yyy006006006/ergoSHIFT-ChocV2/hardware-rev1/README.md

## nekoko edition: Choc V1 / V2 PCB

For this modified PCB, use the [KiCad source](./design_data/ergoSHIFT-rev1-ChocV1-V2-Standard-BSocket-kicad/) and [Gerber ZIP](./ergoSHIFT-rev1-ChocV1-V2-Standard-BSocket-gerber.zip).
Mechanical holes for Kailh Choc V1 / V2 and a back-only socket footprint have been added, preserving the original outline, key positions, mounting holes, and MCU connections.
This is the standard right-handed layout only. Mount switches on the front and 15 Kailh CPG135001S30 sockets on the back.
Direct switch soldering is not supported, and the original reversed-assembly instructions do not apply to this version.
The MCU footprint is for an ATmega32U4 Pro Micro. Use the existing [Rev1 firmware](../firmwares_atmega32u4/), rather than the RP2040 firmware for Rev2.

Saved validation results from 2026-10-02 show 0 DRC errors, 0 unconnected items, and 0 schematic/PCB parity findings.
Remaining findings are 34 DRC warnings (6 silkscreen-to-edge clearance, 4 library footprint mismatches, and 24 silkscreen-over-copper), 1 ERC error (power pin not driven), and 21 ERC warnings.
No check exclusions were added and no rules were relaxed. These results do not establish that every physical button works or that every switch and case will fit.

Modified by nekoko / [yyy006006006](https://github.com/yyy006006006); prepared for publication on 2026-10-18.
Original design: ergoSHIFT (c) by [mizma](https://github.com/mizma/ergoSHIFT). The modified design is also licensed under [CC BY-SA 4.0](https://creativecommons.org/licenses/by-sa/4.0/).
The original Rev1 documentation follows.

---

ergoSHIFT rev1
========================================================================

This is rev1 of the ergoSHIFT.  In this version an Arduino Pro Micro
is soldered onto the main PCB.

To make one you will need:

* [acrylic shell](./acrylic-shell/)
    * For Standard Layout
        * Layers 1, 2, 4: 3mm
        * Layers 3, 5: 2mm
    * For Reverse Layout (Left handed)
        * Layers 1, 2, 3: 3mm
        * Layers 4, 5: 2mm
* [the ergoSHIFT PCB](./pcb/)
* Arduino Pro Micro [SparkFun Qwiic Pro Micro - USB-C (ATmega32U4)](https://www.sparkfun.com/products/15795)
* 15x Kailh low profile (choc v1) switches of your choice
    * I use Kailh Choc v1 Red Pro (Linear and low activation force: 35±10gf with actuation travel: 1.5±0.5mm)
    * Light Blue (gChoc) can be used for even lower actuation force.
* (optionally) 15x Kailh low profile hotswap sockets
* Button Caps (Choose one)
    * [MICRO keycap set](https://junkfoodarcades.com/collections/micro-accessories)
        * You will need to buy two sets of Snackbox Micro keycap sets.
    * [3D printed buttoncaps](../3d-printed-buttoncaps)
* 3x 6x6x8.51mm tact switches
    * I Used [TE Connectivity 3-1825910-5](https://www.te.com/ja/product-3-1825910-5.html)
* 1x 3x6x4.3 horizontal tact switch
    * https://www.newegg.com/p/2S7-01KR-035X0
    * https://shop.yushakobo.jp/collections/all-keyboard-parts/products/a1600ed-01-1
    * [schematics](images/tactile-switch_3x6x4.3.jpg)
* 7x M3 screws (length 20mm)
    * Acryl top 2mm * 2 + 3mm = 7mm
    * PCB 1.6mm
    * Acryl bottom 3mm * 2 = 6mm
    * Rubber feet screw depth = 3mm (using rubber feet below.  adjust for your part)
    * Rubber feet total depth = 8mm (using rubber feet below.  adjust for your part)
    * M3 nut height = 2mm
    * min length = 19.6mm (using rubber feet below.  adjust for your part)
    * max length = 22.6mm (using rubber feet below.  adjust for your part)
* 7x M3 nut and acompanying rubber feet
    * Rubber feet Tochigiya [TM-TK-15](https://www.monotaro.com/p/0933/2486/?displayId=5)
    * The position of the holes are intended for feet radius of less than 8mm
* Some Tin coated wires
* a soldering iron
    * something with enough power is better 
      (i.e. [Hakko FX 600](https://www.hakko.com/japan/products/hakko_fx600_set.html))
    * I recommend changing tips to D type for most Through-hole soldering, or C type if you plan to
      solder SMT as well. (default B tips are harder to use for most PCB soldering)
    * Use 320C ~ 370C temp recommended (can be changed if you know your way around)

## Assembly Instructions

### Ordering PCB

I used [JLCPCB](https://jlcpcb.com/).  Just upload the gerber files in [pcb](pcb) and keep most parameters default.
You may change PCB Qty and PCB Color if you like.  All other parameters should be kept the same.

### Ordering Buttons

#### Snackbox Micro button caps

ergoSHIFT is compatible with Snackbox Micro button caps.

You can purchase them [HERE](https://junkfoodarcades.com/collections/micro-accessories)

#### 3D printed buttons

_**Currently verifying design**_

If you have a 3D printer, print at your own will.  Files are found [here](../3d-printed-buttoncaps/).

* [ergoSHIFT-ButtonCapBig.stl](../3d-printed-buttoncaps/ergoSHIFT-ButtonCapBig.stl) 
  is used for the thumb button. 1 board needs 1 of this button.
* [ergoSHIFT-Buttoncap.stl](../3d-printed-buttoncaps/ergoSHIFT-ButtonCapBig.stl) is used for all other buttons.
  1 board needs 14 of this button.
* [ergoSHIFT-FullSetButtonCaps.stl](../3d-printed-buttoncaps/ergoSHIFT-FullSetButtonCaps.stl) is an STL file 
  containing 1 full set of buttons + extra(26 small and 2 big.).  If your 3D printing service allows 28 or more shells, it may be cheaper to print in one batch using this STL file.
    * Print size needs to be bigger than X：99.4901mm x Y： 91.7951mm x Z： 15.0000mm
    * To accomodate for the buttons in the 100mm x 100mm x 100mm size limit in some Printing services,
      This STL file has two layers of buttons arranged on top of each other.  This type of layout is only
      possible on print technology such as SLS or MJF.  Check with your 3D Printing service.
    * If your 3D Printing service does not support this type of data, use individual cap data to print.

Insertion portion may need to be adjusted in size for your 3D Printer and settings to fit snugly to the switch.
You may use some of the printer features but if that doesn't work, you might want to edit the original model.
Model data are found in [here](../3d-printed-buttoncaps/design_data/) in a [FreeCAD](https://www.freecadweb.org/)
file format.

Also, since the insertion portion requires a fairly tight tolerance which is not easily achieved by 3D printers,
the models are modelled slightly on the larger side.

I have had fairly good results with this model using SLS/MJF Nylon print but sometimes it is too large.
If the legs turn out too large to fit, use sandpaper to adjust the width of the legs.

#### Materials Consideration

* Nylon
    * May be a good place to start for tensile strength and good chemical stability.
    * can be pretty strong if printed using SLS process at some printing services
    * may be prone to warping.  not good for humid places.
* UV Resin
    * Also pretty strong as a material, and stronger to humidity.
    * Maybe slightly more brittle than Nylon

### Ordering Acrylic cuts

I use [Elecrow](https://www.elecrow.com/acrylic-cutting.html) to cut acrylic.

Upload the .zip file in [acrylic-shell](acrylic-shell/) to the Elecrow Acrylic cut service to order.
.Zip file includes the dxf file and the dimentions.txt file.  PDF is just for reference.

Use the following thickness:

* For Standard Layout
    * Layers 1, 2, 4: 3mm
    * Layers 3, 5: 2mm
* For Reverse Layout (Left handed)
    * Layers 1, 2, 3: 3mm
    * Layers 4, 5: 2mm

The original design file (FreeCAD file) can be found [here](./design_data/acryl-design/).

The Acrylic should look like the following (with PCB stacked)

ergoSHIFT-rev1-Acrylic-Stack

(*) Above image is for standard layout (right handed)

### Assembly

1. Solder all the Choc v1 switches and the tactile switches.  make sure you populate the side with the logo.
    * If you populate the side with the logo on the left, the parts only goes in in the correct orientation.
        * For reverse layout, implement the buttons on the other side as shown in [this picture](images/Reverse-Layout-Solering.jpg)
    * If you use the hot-swap sockets, those will go on the back. (see silk screen on back side for orientation)
        * For hotswap sockets, pre-solder one side of the pad on PCB, place the socket, heat the pre-solder while
          pressing down on the socket to attach the socket.  After It is attached, solder the other side fully and then add more solder on the pre-soldered side.
2. Solder the Pro Micro Qwiic from the bottom side of the PCB up into the slit (USB socket should be between the cut-outs on the board, facing up) (Following instruction is how I did it.  There may be other ways) (This should NOT BE REVERSED for left hand layout)
    1.  First, mask the back side holes on the PCB with masking tape, and poke a small hole in each Through-hole with a needle. (This is to stop creating solder filets on the side the ProMicro will be soldered to.
        Mask Through-holes
    2. Insert a short (2~3cm) tin coated wire in the hole and solder onto the board.  Then cut the excess wire on the front side.
       Tin Coated Wires
       Place Wire
       Solder backside
    3. Remove the masking tape.  The back side should have a flat solder filled hole with wires coming out the middle.
       Flat Filled Through-holes
    4. Place the Pro-Micro into the wires, tape it down to place.  Also tape the entire front side of 
       the soldered through-holes so the wires don't fall when solder melts.
       Place Pro-Micro into Wires
    5. Solder the Pro-Micro to the tin-coated wire.
       Soldered Pro-Micro
3. stack the Acryl and PCB in following order: Layer 01, Layer 02, PCB, Layer 03, Layer 04 and Layer 05.
    * If you use 2 Layer 4s, the order should be 01, 02, 03, 04, 04.
4. Screw on the M3 screws with the nut on all 7 locations.  Rubber feet should be inserted at least in the 4 corners between the nut and the acrylic.

It should look like the following when assembled.

ergoSHIFT-rev1
ergoSHIFT-rev1

### Pro-Tip 1. Filing the Acrylic Edges

Acrylic Edges after laser cutting can be quite sharp and do not feel good.
You may want to file the edges with sandpaper (#400 is a nice place to start) to remove the edges 
on the top acrylic layer so it does not feel bad.

### Pro-Tip 2. Customizing design

You can also insert some artwork below the top acrylic layer as below:

ergoSHIFT-rev1_with_artwork1
ergoSHIFT-rev1_with_artwork1
ergoSHIFT-rev1_with_artwork2

(*) Above sample Artwork based on an In-Game Screenshot + Official Fan-kit (©Cygames & ARK SYSTEM WORKS)

Stencil for the artwork can be found below (Page size set to A4):

* [Stencil SVG](./images/ergoSHIFT-stencil.svg)
* [Stencil PNG 300dpi](./images/ergoSHIFT-stencil.png)
* [Southpaw Stencil SVG](./images/ergoSHIFT-stencil-reverse.svg)
* [Southpaw Stencil PNG 300dpi](./images/ergoSHIFT-stencil-reverse.png)

To cut the stencil, use one of the top acrylic plates as cutting guides (don't trust the acuracy
of the printed stencil mark, they are good enough to use as design guide, but not acurate enough for 
final cutting guide).  It is easy to cut if you tape the plate on top of the print and use a sharp
designers knife.

Stencil-Cutting

## License and Acknowlegements



PCB design licensed under [CC BY-SA 4.0](https://creativecommons.org/licenses/by-sa/4.0/) by mizma

Acrylic sandwitching shell heavily inspired by [Mille-Feuille](https://pomegd.booth.pm/items/2685530) 
by [@pomegd](https://twitter.com/pomegd)

PCB design uses the following libraries or derivatives of the design:

* [keyswitches.pretty](https://github.com/daprice/keyswitches.pretty) by [daprice](https://github.com/daprice) ([CC BY-SA 4.0](https://creativecommons.org/licenses/by-sa/4.0/))
* [ProMicroKiCad](https://github.com/Biacco42/ProMicroKiCad) by [Biacco42](https://github.com/Biacco42), derived from [teensy\_library](https://github.com/XenGi/teensy_library) by Ricardo Band ([MIT License](https://opensource.org/licenses/mit-license.php))
