yyy006006006/ergoSHIFT-ChocV2/firmwares_atmega32u4/LUFA/README.md

[日本語はこちら](README_ja.md)

## LUFA Switch/XInput hybrid Fightstick firmware

This firmware is a derivative of the awesome [LUFAHybridFightstick](https://github.com/CrazyRedMachine/LUFAHybridFightstick) by [CrazyRedMachine](https://github.com/CrazyRedMachine)

## nekoko Web configuration firmware (experimental)

The `nekoko-webconfig-v1.hex` build adds browser-based remapping for the 11 large buttons on the **Rev1 Choc V1/V2 Standard-BSocket** board. Modified by nekoko on 2026-10-18. The changes are in `NekokoMapping.*`, `NekokoConfig.*`, `LUFAHybridFightstick.ino`, `Descriptors.c`, and `XS_HID.c`. Source and firmware remain under the [GPL v3 license](LICENSE).

Install this firmware before shipping an assembled controller. Buyers do not reflash the firmware to change their button assignments. They hold the middle of the three small upper buttons while connecting USB, open the web configurator in desktop Chrome or Edge, and connect to **ergoSHIFT Configuration**. They select the physical button in the upper diagram, select an Xbox-style input in the lower diagram, and choose **Save to device**. Unplug and reconnect normally to resume playing. Direction controls, HOME, START, and existing SOCD handling remain fixed. The web app reads the stored map back before reporting a successful save.

The [web app source](../../web-configurator/) includes the on-screen connection guide and JSON backup/import. Configuration is stored in two alternating EEPROM records at addresses 32 and 64; legacy mode settings at addresses 0–9 are preserved. Normal XInput/Switch USB descriptors are retained; configuration mode uses a vendor-defined HID collection and the existing Switch-mode VID/PID. No new USB ID allocation is implied.

Validation so far: host-side C mapping tests, invalid-data rejection, 25 interrupted-save points, browser UI tests, AVR compilation, and Flash readback verification on the assembled controller. Holding the middle small button while connecting USB successfully entered configuration mode. Chrome read the stored mapping, saved a BACK/R3 swap, and read back the matching result over WebHID. After unplugging and reconnecting normally, Windows XInput recorded all three presses of the upper large button as R3, confirming that the saved mapping survived the power cycle. Other physical buttons and individual games have not yet been retested with this firmware. A double reset exposed this unit's Caterina COM port for about 7.5 seconds; a single reset did not expose a COM port in that observation. The original `LUFAHybridFightstick.ino.hex` is retained unchanged for recovery.

Build with Arduino CLI 1.5.1, the [Arduino-LUFA 0.93 board package](https://github.com/CrazyRedMachine/Arduino-Lufa/releases/tag/0.93), Bounce2 v2.71, and Arduino AVR GCC 7.3.0-atmel3.6.1-arduino7. Select `leonardo` (LUFA), ATmega32U4, 16 MHz. The current build uses 10,210 bytes of Flash and 466 bytes of static RAM. Only the application Flash is programmed; the bootloader, fuses, and EEPROM are not overwritten during installation.

## Source download and rebuild

The complete modified application source, the Arduino-LUFA platform/core, LUFA, EEPROM and Bounce2 2.71 sources used for the supplied build are included in this repository. Download the repository as a ZIP to obtain these files and [full licenses/notices](../../LICENSES.txt). The external general-purpose build tools are Arduino CLI 1.5.1 and AVR GCC 7.3.0-atmel3.6.1-arduino7 (avr-libc 2.0.0).

With PowerShell 7, Arduino CLI installed, and Arduino AVR Boards 1.8.6 installed for the compiler, run `./build-source.ps1` from this directory. `-ArduinoCli` and `-CompilerPath` can specify the installed tools. Output is `tmp/source-build/avr/LUFAHybridFightstick.ino.hex`. The script uses `source-dependencies/arduino-user` without modifying the user's Arduino configuration.

For installation on the tested ATmega32U4 / 16 MHz Pro Micro with Caterina, connect by USB, double-reset to expose its short-lived bootloader serial port, then flash the application HEX with avrdude using `-p atmega32u4 -c avr109 -P <bootloader-port> -b 57600 -D -U flash:w:<hex-path>:i`. Read back and verify Flash. Do not overwrite the bootloader, fuses or EEPROM. This unit has no signature lock or installation keys. Other bootloaders may require a different reset procedure. After flashing, connect while holding the middle small button to use WebHID configuration; reconnect without holding buttons to play.

Complete Corresponding Source and the installation information above are available for free download to anyone possessing the supplied software. This availability is maintained for at least three years after each product delivery and for as long as spare parts or support are offered for this model.

## Acknowledgments

This work is a fork of [LUFAHybridFightstick](https://github.com/CrazyRedMachine/LUFAHybridFightstick) by [CrazyRedMachine](https://github.com/CrazyRedMachine) and
is based on [fluffymadness' ATMega32U4-Switch-Fightstick](https://github.com/fluffymadness/ATMega32U4-Switch-Fightstick)
and [bootsector's XInputPadMicro](https://github.com/bootsector/XInputPadMicro), with a QoL features added by CrazyRedMachine.

This fork is customized for the needs of ergoSHIFT features

* Remapped keys to work with ergoSHIFT layout
* Removed support for analog stick
* reorganized the customization button settings for SOCD and other features
    * SOCD config is now only at startup and only provide three common modes (All Neutral, Hitbox and Gafro)
    * Added feature to configure vertical input inversion.  Useful when using Hitbox layout on non-fighting games.

## Features

### Gamepad modes

Hold "select" as you plug the controller to make it a Nintendo Switch controller.

Hold "start" as you plug the controller to make it an XInput controller.

Gamepad mode is persistent across plugging and unplugging the controller, so if you don't press anything while plugging the controller, it will stay in the last used mode. 

### DPAD modes

You can switch seamlessly between the 3 stick modes by pressing START+SELECT+(LEFT/UP/RIGHT)

- UP: DPAD 
- LEFT: Fake Left Analog (DPad is mapped to L-Analog)
- RIGHT: Fake Right Analog (DPad is mapped to R-Analog)

DPAD mode is also persistent.

### Real analog support

This function has been removed since ergoSHIFT has no plans of adding analog inputs

### Simulated home button

This is also removed since we have custom hardware that support home buttons

### SOCD Cleaning

* HOME at startup = All NEUTRAL
* RS at startup = Hitbox style SOCD cleaning (Up+Down=Up, Left+Right=Neutral)
* LS at startup = Gafro style SOCD cleaning (Up+Down=Up, Left+Right=Last Input)

You can use the Reset button on the ergoSHIFT while holding the buttons above to change mode.

### UP-DOWN inverse

Since ergoSHIFT is a Hitbox style controller, Up and Down button layout is a little convoluted for normal use outside its fighting game use-case.
I have added inverting the UP/DOWN input as a feature so the controller can be used a little easier on normal games... (although it still feels a little unweildy TBH.)

* To invert UP and DOWN inputs, press UP at startup.
* To set to normal mode, press DOWN at startup.

## Building Instructions

- Download Arduino IDE, 
- Download the Bounce2 Library inside the Arduino IDE
- Add `https://github.com/CrazyRedMachine/Arduino-Lufa/raw/master/package_arduino-lufa_index.json` as an Additional Board Manager URL (in `File -> Preferences` menu)
- Install LUFA AVR Boards from the Board Manager
- Select Arduino Leonardo (LUFA) as your board type (Pro-Micro is a compatible board to Leonardo)
- Upload the code and Have Fun

### How to upload

When you reflash AVR boards with USB HID device software, Arduino IDE cannot automatically reset and flash the software.
You will need to press reset button on the AVR board (SW_RST1 on ergoSHIFT) to put it into Bootloader mode to reflash.
When you use Sparkfun Qwiik ProMicro 5V, you will need to double-click the reset button to put it into Bootloader.

I recommend setting up VSCode Arduino plugin.  If you open this directory with VSCode, it is already set up so all you need to do is
run Arduino: Verify from the command pallet (You will still need to install Arduino, Bounce Library and add the LUFA board manager URL before you can run verify).
The .hex file will be created in the Build folder.

Take the .hex file and use [QMK Toolbox](https://github.com/qmk/qmk_toolbox) to flash the .hex file.

In QMK Toolbox, Press OPEN and select the .hex file you just created, (or just use the one in the repository).  Select ATMega32U4 from the dropdown menu at the top right corner.
Click the Reset button on the Pro-Micro (Double-Click on Qwiik ProMicro USB-C variant).  When you see the "Caterina device connected (usbser): ~~~" text, press Flash button.

This method, while requires extra software setups, is more reliable than trying to time the Reset while Arduino IDE is doing it's thing...

## Pinout

Configurable in the .ino

The key config is already setup to match ergoSHIFT wiring.

```C
/* PINOUT (follows Nintendo naming (X=up, B=down)) */
#define PIN_UP    7
#define PIN_DOWN  4
#define PIN_LEFT  3
#define PIN_RIGHT 5
#define PIN_A     MISO         //XBOX B
#define PIN_B     10           //XBOX A  
#define PIN_X     15           //XBOX Y
#define PIN_Y     MOSI         //XBOX X     
#define PIN_L     21           //XBOX LB
#define PIN_R     20           //XBOX RB
#define PIN_ZL    8            //XBOX LT
#define PIN_ZR    19           //XBOX RT
#define PIN_LS    6            //XBOX LS (left analog click)
#define PIN_RS    9            //XBOX RS (right analog click)
#define PIN_PLUS  2            //XBOX START
#define PIN_MINUS 18           //XBOX BACK
#define PIN_HOME  1
```

For southpaw version, swap the PIN_LEFT and PIN_RIGHT definition and recompile.

```C
/* PINOUT (follows Nintendo naming (X=up, B=down)) */
#define PIN_UP    7
#define PIN_DOWN  4
#define PIN_LEFT  5
#define PIN_RIGHT 3
#define PIN_A     MISO         //XBOX B
#define PIN_B     10           //XBOX A  
#define PIN_X     15           //XBOX Y
#define PIN_Y     MOSI         //XBOX X     
#define PIN_L     21           //XBOX LB
#define PIN_R     20           //XBOX RB
#define PIN_ZL    8            //XBOX LT
#define PIN_ZR    19           //XBOX RT
#define PIN_LS    6            //XBOX LS (left analog click)
#define PIN_RS    9            //XBOX RS (right analog click)
#define PIN_PLUS  2            //XBOX START
#define PIN_MINUS 18           //XBOX BACK
#define PIN_HOME  1
```

## Donation

If this project helped you, please consider going to the original works and donate to the source work ;)
