yyy006006006/ergoSHIFT-ChocV2/3d-printed-buttoncaps/design_data/ergoSHIFT-ButtonCapBig-ChocV2-MX.step

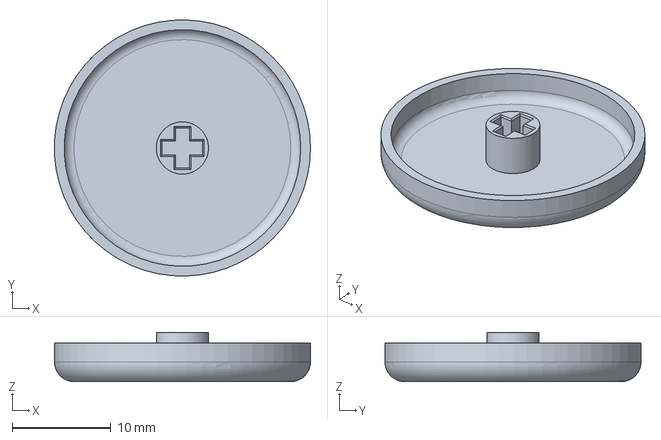
[picture p1: CAD file, 2026-10-18]
3d-printed-buttoncaps/design_data/ergoSHIFT-ButtonCapBig-ChocV2-MX.step
26.0 x 26.0 x 5.00 mm
