yyy006006006/ergoSHIFT-ChocV2/3d-printed-buttoncaps/design_data/ergoSHIFT-ButtonCap-ChocV2-MX.step

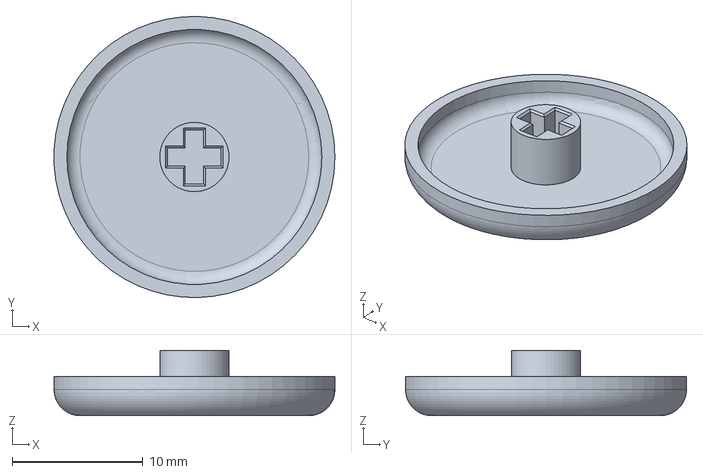
[picture p2: CAD file, 2026-10-18]
3d-printed-buttoncaps/design_data/ergoSHIFT-ButtonCap-ChocV2-MX.step
21.5 x 21.5 x 5.00 mm
