yyy006006006/ergoSHIFT-ChocV2/3d-printed-buttoncaps/ergoSHIFT-ButtonCap-ChocV2-MX.stl

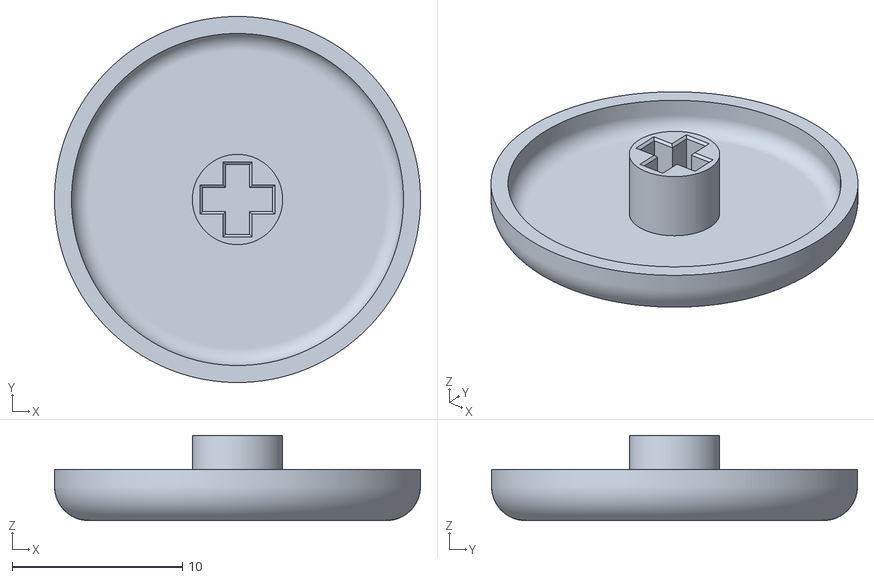
[picture p3: CAD file, 2026-10-18]
3d-printed-buttoncaps/ergoSHIFT-ButtonCap-ChocV2-MX.stl
21.5 x 21.5 x 5.00
