yyy006006006/ergoSHIFT-ChocV2/(list of files, cad)

Other CAD files:
3d-printed-buttoncaps/ergoSHIFT-ButtonCapBig-ChocV2-MX.stl
