yyy006006006/ergoSHIFT-ChocV2/hardware-rev1/design_data/ergoSHIFT-rev1-ChocV1-V2-Standard-BSocket-kicad/ergoSHIFT-rev1-ChocV1-V2-Standard-BSocket.kicad_pcb

## KiCad design hardware-rev1/design_data/ergoSHIFT-rev1-ChocV1-V2-Standard-BSocket-kicad/ergoSHIFT-rev1-ChocV1-V2-Standard-BSocket.kicad_pcb (2026-10-18)

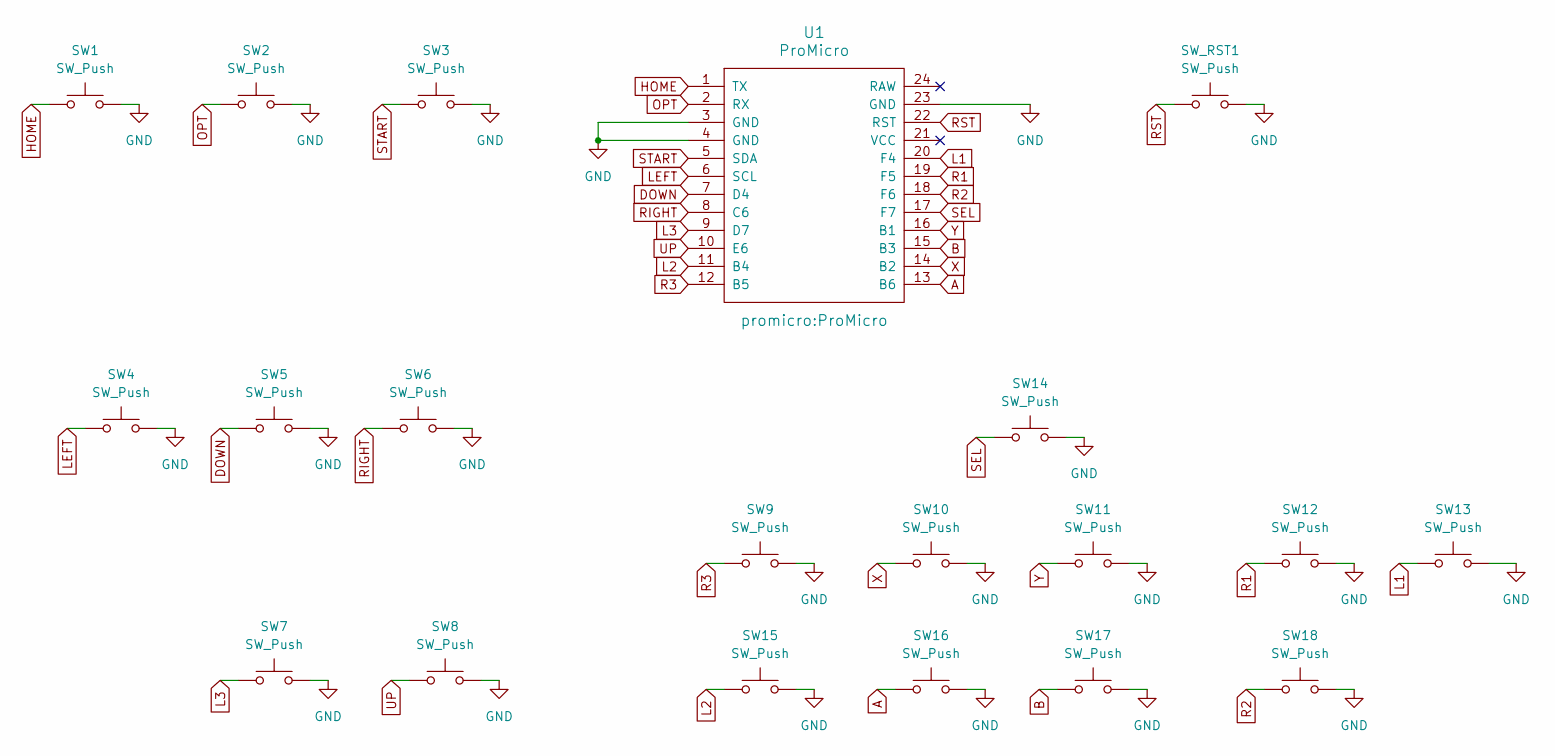
[picture p4: schematic ergoSHIFT-rev1-ChocV1-V2-Standard-BSocket.kicad_sch, ergoSHIFT]

Parts:
SW1, SW2, SW3: SW_Push; SW_PUSH_6mm_H8.5mm
SW4, SW5, SW6, SW7, SW8, SW9, SW10, SW11, SW12, SW13, SW14, SW15, SW16, SW17, SW18: SW_Push; SW_Choc_V1_V2_Standard_BSocket
SW_RST1: SW_Push; SW_Tactile_Yushakobo 3x6x4.3mm
U1: ProMicro

Connections:
A: SW16.1, U1.13 (B6)
B: SW17.1, U1.15 (B3)
DOWN: SW5.1, U1.7 (D4)
GND: SW1.2, SW2.2, SW3.2, SW4.2, SW5.2, SW6.2, SW7.2, SW8.2, SW9.2, SW10.2, SW11.2, SW12.2, SW13.2, SW14.2, SW15.2, SW16.2, SW17.2, SW18.2, SW_RST1.2, U1.3 (GND), U1.4 (GND), U1.23 (GND)
HOME: SW1.1, U1.1 (TX)
L1: SW13.1, U1.20 (F4)
L2: SW15.1, U1.11 (B4)
L3: SW7.1, U1.9 (D7)
LEFT: SW4.1, U1.6 (SCL)
OPT: SW2.1, U1.2 (RX)
R1: SW12.1, U1.19 (F5)
R2: SW18.1, U1.18 (F6)
R3: SW9.1, U1.12 (B5)
RIGHT: SW6.1, U1.8 (C6)
RST: SW_RST1.1, U1.22 (RST)
SEL: SW14.1, U1.17 (F7)
START: SW3.1, U1.5 (SDA)
UP: SW8.1, U1.10 (E6)
X: SW10.1, U1.14 (B2)
Y: SW11.1, U1.16 (B1)

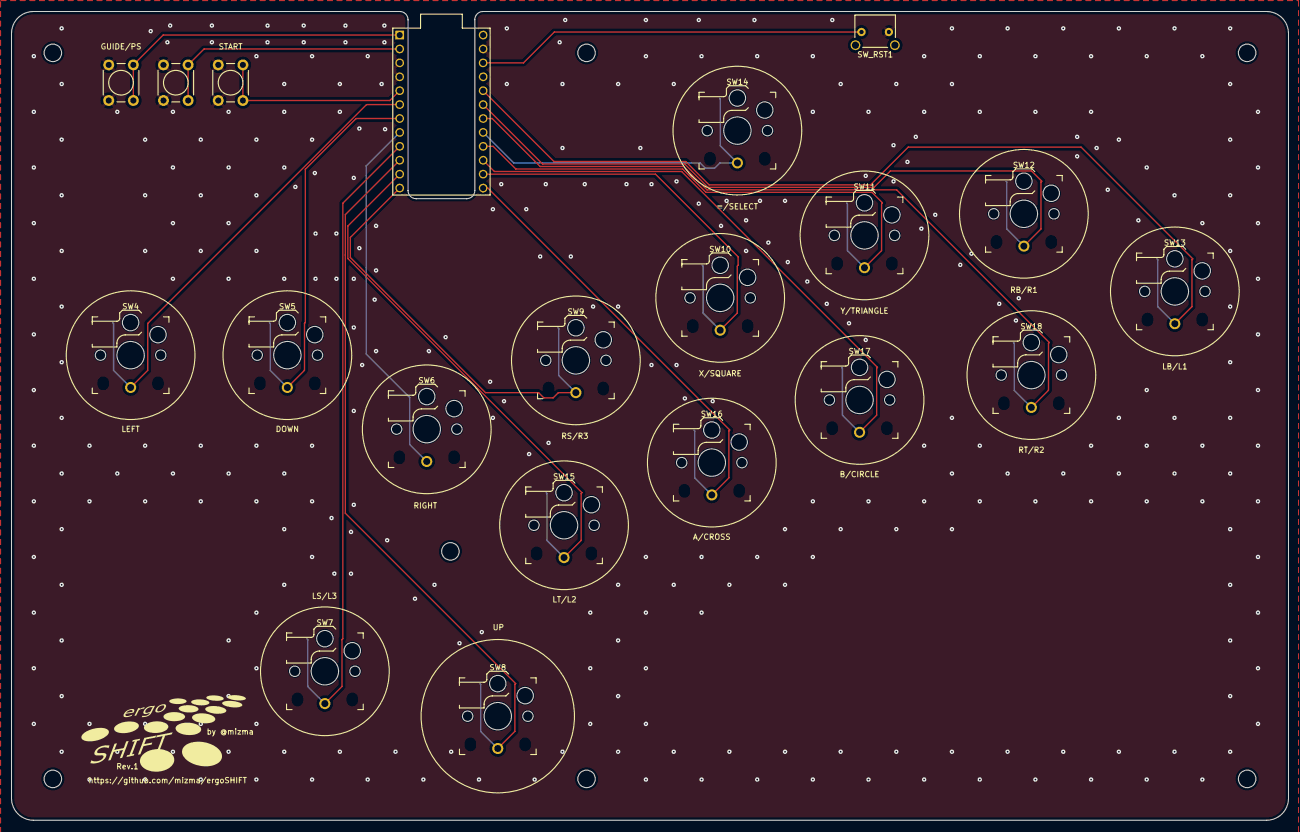
[picture p5: board ergoSHIFT-rev1-ChocV1-V2-Standard-BSocket.kicad_pcb from above]

Board: 2 copper layers, 233.2 x 147.7 mm, 20 parts (0 on the bottom side), 20 nets.
