yyy006006006/ergoSHIFT-ChocV2/firmwares_atmega32u4/LUFA/LUFAHybridFightstick/XS_HID.c

#include "XS_HID.h"
#include "NekokoConfig.h"
#include "NekokoMapping.h"
static USB_JoystickReport_Input_t ReportData;
static USB_JoystickReport_XInput_t XInput_ReportData;

// Configures hardware and peripherals, such as the USB peripherals.
void SetupHardware(bool xinput_mode) {
  
  //set xinput_mode for descriptors.h/.c
  xs_xinput = xinput_mode;
  desc_set_xinput_mode(xinput_mode);
  // We need to disable watchdog if enabled by bootloader/fuses.
  MCUSR &= ~(1 << WDRF);
  wdt_disable();
  // We need to disable clock division before initializing the USB hardware.
  clock_prescale_set(clock_div_1);
  // We can then initialize our hardware and peripherals, including the USB stack.
  // The USB stack should be initialized last.
  USB_Init();
}

// Fired to indicate that the device is enumerating.
void EVENT_USB_Device_Connect(void) {
  // We can indicate that we're enumerating here (via status LEDs, sound, etc.).
}

// Fired to indicate that the device is no longer connected to a host.
void EVENT_USB_Device_Disconnect(void) {
  // We can indicate that our device is not ready (via status LEDs, sound, etc.).
}

// Fired when the host set the current configuration of the USB device after enumeration.
void EVENT_USB_Device_ConfigurationChanged(void) {

  if (nekoko_config_mode) {
    Endpoint_ConfigureEndpoint(JOYSTICK_IN_EPADDR, EP_TYPE_INTERRUPT, 8, 1);
    return;
  }

  if (!xs_xinput) Endpoint_ConfigureEndpoint(JOYSTICK_OUT_EPADDR, EP_TYPE_INTERRUPT, JOYSTICK_EPSIZE, 1);
  else Endpoint_ConfigureEndpoint((ENDPOINT_DIR_IN | 3), EP_TYPE_INTERRUPT, 32, 1);
  
  Endpoint_ConfigureEndpoint(JOYSTICK_IN_EPADDR, EP_TYPE_INTERRUPT, xs_xinput? JOYSTICK_EPSIZE_XINPUT: JOYSTICK_EPSIZE, 1);

}

// Process control requests sent to the device from the USB host.
void EVENT_USB_Device_ControlRequest(void) {
  if (nekoko_config_mode) { nekoko_config_request(); return; }
  //No controlRequest received from the switch, so only handled in xinput mode 
 if (xs_xinput){
  /* Handle HID Class specific requests */
  switch (USB_ControlRequest.bRequest) {
  case HID_REQ_GetReport:
    if (USB_ControlRequest.bmRequestType
        == (REQDIR_DEVICETOHOST | REQTYPE_CLASS | REQREC_INTERFACE)) {
      Endpoint_ClearSETUP();

      /* Write the report data to the control endpoint */
      Endpoint_Write_Control_Stream_LE(&XInput_ReportData, 20);
      Endpoint_ClearOUT();
    }
    break;
  }
 }
}

// Process and deliver data from IN and OUT endpoints.
void HID_Task(void) {
    /* Device must be connected and configured for the task to run */
if (USB_DeviceState != DEVICE_STATE_Configured)
    return;

void* Address = &XInput_ReportData;
uint16_t    Size    = 20;

//no OUT endpoint for xinput in this firmware
if (!xs_xinput){
  Address = &ReportData;
  Size = sizeof(ReportData);
  
   // We'll start with the OUT endpoint.
  Endpoint_SelectEndpoint(JOYSTICK_OUT_EPADDR);
  // We'll check to see if we received something on the OUT endpoint.
  if (Endpoint_IsOUTReceived())
  {
    // If we did, and the packet has data, we'll react to it.
    if (Endpoint_IsReadWriteAllowed())
    {
      // We'll create a place to store our data received from the host.
      USB_JoystickReport_Output_t JoystickOutputData;
      // We'll then take in that data, setting it up in our storage.
      Endpoint_Read_Stream_LE(&JoystickOutputData, sizeof(JoystickOutputData), NULL);
      // At this point, we can react to this data.
      // However, since we're not doing anything with this data, we abandon it.
    }
    // Regardless of whether we reacted to the data, we acknowledge an OUT packet on this endpoint.
    Endpoint_ClearOUT();
  }
}
/* Select the Joystick Report Endpoint */
  Endpoint_SelectEndpoint(JOYSTICK_IN_EPADDR);

  /* Check to see if the host is ready for another packet */
  if (Endpoint_IsINReady()) {
    /* Write Joystick Report Data */
    Endpoint_Write_Stream_LE(Address, Size, NULL);

    /* Finalize the stream transfer to send the last packet */
    Endpoint_ClearIN();
    /* Clear the report data afterwards */
    memset(Address, 0, Size);
    if (xs_xinput) (*((USB_JoystickReport_XInput_t *) Address)).rsize = 20;
  }
}

void send_pad_state(void){  
  generate_report();
  HID_Task();
  USB_USBTask();
}

void generate_report_xinput(){
  // HAT
    if (buttonStatus[BUTTONUP]){XInput_ReportData.digital_buttons_1 |= XBOX_DPAD_UP;}
    if (buttonStatus[BUTTONDOWN]){XInput_ReportData.digital_buttons_1 |= XBOX_DPAD_DOWN;}
    if (buttonStatus[BUTTONLEFT]){XInput_ReportData.digital_buttons_1 |= XBOX_DPAD_LEFT;}
    if (buttonStatus[BUTTONRIGHT]){XInput_ReportData.digital_buttons_1 |= XBOX_DPAD_RIGHT;}
    
  // analogs    
    XInput_ReportData.l_x = buttonStatus[AXISLX] * 257 + -32768;
    XInput_ReportData.l_y = buttonStatus[AXISLY] * -257 + 32767;
    XInput_ReportData.r_x = buttonStatus[AXISRX] * 257 + -32768;
    XInput_ReportData.r_y = buttonStatus[AXISRY] * -257 + 32767;
    
  // buttons
    if (buttonStatus[BUTTONSTART]){XInput_ReportData.digital_buttons_1 |= XBOX_START;}
    if (buttonStatus[BUTTONSELECT]){XInput_ReportData.digital_buttons_1 |= XBOX_BACK;}
    if (buttonStatus[BUTTONL3]){XInput_ReportData.digital_buttons_1 |= XBOX_LEFT_STICK;}
    if (buttonStatus[BUTTONR3]){XInput_ReportData.digital_buttons_1 |= XBOX_RIGHT_STICK;}

    /* xbox buttons are not in the same position as nintendo controllers */
    if (buttonStatus[BUTTONA]){XInput_ReportData.digital_buttons_2 |= XBOX_B;}
    if (buttonStatus[BUTTONB]){XInput_ReportData.digital_buttons_2 |= XBOX_A;}
    if (buttonStatus[BUTTONX]){XInput_ReportData.digital_buttons_2 |= XBOX_Y;}
    if (buttonStatus[BUTTONY]){XInput_ReportData.digital_buttons_2 |= XBOX_X;}

    if (buttonStatus[BUTTONLB]){XInput_ReportData.digital_buttons_2 |= XBOX_LB;}
    if (buttonStatus[BUTTONRB]){XInput_ReportData.digital_buttons_2 |= XBOX_RB;}
    if (buttonStatus[BUTTONHOME]){XInput_ReportData.digital_buttons_2 |= XBOX_HOME;}

    if (buttonStatus[BUTTONLT]){XInput_ReportData.lt = 0xFF;}
    if (buttonStatus[BUTTONRT]){XInput_ReportData.rt = 0xFF;}    
}

void generate_report_switch(){
// HAT
    if ((buttonStatus[BUTTONUP]) && (buttonStatus[BUTTONRIGHT])){ReportData.HAT = DPAD_UPRIGHT_MASK_ON;}
    else if ((buttonStatus[BUTTONDOWN]) && (buttonStatus[BUTTONRIGHT])) {ReportData.HAT = DPAD_DOWNRIGHT_MASK_ON;} 
    else if ((buttonStatus[BUTTONDOWN]) && (buttonStatus[BUTTONLEFT])) {ReportData.HAT = DPAD_DOWNLEFT_MASK_ON;}
    else if ((buttonStatus[BUTTONUP]) && (buttonStatus[BUTTONLEFT])){ReportData.HAT = DPAD_UPLEFT_MASK_ON;}
    else if (buttonStatus[BUTTONUP]) {ReportData.HAT = DPAD_UP_MASK_ON;}
    else if (buttonStatus[BUTTONDOWN]) {ReportData.HAT = DPAD_DOWN_MASK_ON;}
    else if (buttonStatus[BUTTONLEFT]) {ReportData.HAT = DPAD_LEFT_MASK_ON;}
    else if (buttonStatus[BUTTONRIGHT]) {ReportData.HAT = DPAD_RIGHT_MASK_ON;}
    else{ReportData.HAT = DPAD_NOTHING_MASK_ON;}

// analogs
  ReportData.LX = buttonStatus[AXISLX];
  ReportData.LY = buttonStatus[AXISLY];
  ReportData.RX = buttonStatus[AXISRX];
  ReportData.RY = buttonStatus[AXISRY];

// Buttons
  if (buttonStatus[BUTTONA]) {ReportData.Button |= A_MASK_ON;}
  if (buttonStatus[BUTTONB]) {ReportData.Button |= B_MASK_ON;}
  if (buttonStatus[BUTTONX]) {ReportData.Button |= X_MASK_ON;}
  if (buttonStatus[BUTTONY]) {ReportData.Button |= Y_MASK_ON;}
  if (buttonStatus[BUTTONLB]) {ReportData.Button |= LB_MASK_ON;}
  if (buttonStatus[BUTTONRB]) {ReportData.Button |= RB_MASK_ON;}
  if (buttonStatus[BUTTONLT]) {ReportData.Button |= ZL_MASK_ON;}
  if (buttonStatus[BUTTONRT]) {ReportData.Button |= ZR_MASK_ON;}
  if (buttonStatus[BUTTONSTART]){ReportData.Button |= START_MASK_ON;}
  if (buttonStatus[BUTTONSELECT]){ReportData.Button |= SELECT_MASK_ON;}
  if (buttonStatus[BUTTONHOME]){ReportData.Button |= HOME_MASK_ON;}
  if (buttonStatus[BUTTONL3]){ReportData.Button |= L3_MASK_ON;}
  if (buttonStatus[BUTTONR3]){ReportData.Button |= R3_MASK_ON;}
  if (buttonStatus[BUTTONCAPTURE]){ReportData.Button |= CAPTURE_MASK_ON;}
}

static void generate_report(){
  // 起動時のモード選択・SOCD判定は実ボタンのまま、ゲームへの出力だけ入れ替える。
  uint8_t physical[22];
  memcpy(physical, buttonStatus, sizeof(physical));
  nekoko_mapping_apply(buttonStatus);
  if (xs_xinput) generate_report_xinput();
  else generate_report_switch();
  memcpy(buttonStatus, physical, sizeof(physical));
}
