yyy006006006/ergoSHIFT-ChocV2/(commit log)

2026-10-18 Choc V1・V2対応基板とChoc V2キャップを公開用に追加
2026-10-18 派生版の公開説明を英語に統一
2026-10-18 Webからのボタン配置変更と保存に対応
2026-10-18 購入者向け設定ページへのリンクを追加
2026-10-18 接続成功後だけキーマップを表示し説明を簡潔化
2026-10-18 依存ソースとライセンス全文を同梱し設定画面をライト表示に変更
